devilthanh/Thesis-eSwitch-Project/Assets/sanpham.jpg

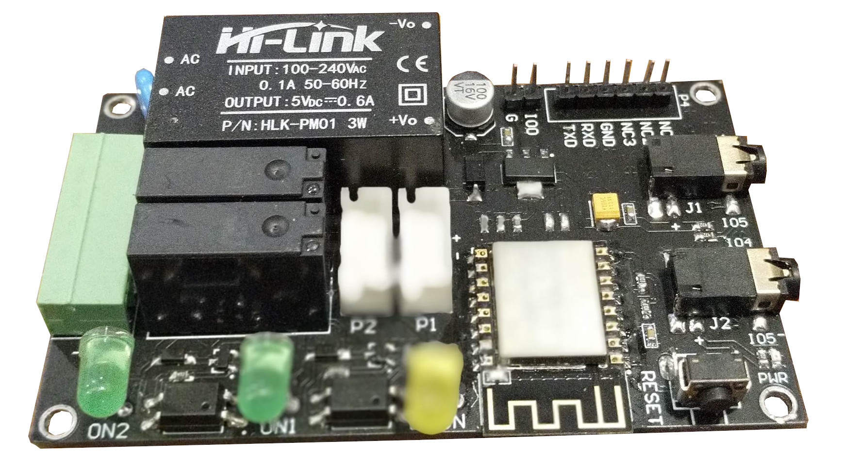
Assets/sanpham.jpg
