devilthanh/Thesis-eSwitch-Project/README.md

# [Thesis] eSwitch Project by Vo Ha Thanh
