devilthanh/Thesis-eSwitch-Project/Assets/sodokhoimach.docx

01 LED thông báo trạng thái mạng

02 relay HF46

02 LED trạng thái relay

02 cảm biến giao tiếp I2C qua jack audio 3.5mmm

02 nút nhấn cảm ứng điện dung

Nguồn Hi-link HLK-PM01 5VDC 3W

01 LED nguồn

ASM1117 3.3V

MCU

ESP8266-12F
