devilthanh/Thesis-eSwitch-Project/Assets/sodofirmware.docx

Save

Load

HTTPS

…

Firebase

Bộ nhớ EEPROM ảo để lưu các thiết lập cần thiết

Vòng lặp của đối tượng xử lý chính

Danh sách liên kết chứa các đối tượng thiết bị.

Bắt đầu

Thiết bị 1

Thiết bị 2

Thiết bị 3

Thiết bị n
