devilthanh/Thesis-eSwitch-Project/Assets/sodokhoitongquat.docx

…

Hệ thống nhiều thiết bị của người dùng n

Hệ thống nhiều thiết bị của người dùng 2

Hệ thống nhiều thiết bị của người dùng 1

…

Web App/

Mobile App

Người dùng n

Firebase Realtime Database

Web App/

Mobile App

Người dùng 2

Người dùng 1

Web App/

Mobile App
