devilthanh/Thesis-eSwitch-Project/Assets/sodoweb.docx

Thao tác của người dùng

Cập nhật giao diện

Sự kiện thao tác

Giao diện được thiết kế bằng HTML và CSS

HTTPS

Chương trình chính của giao diện được xử lý bằng Javascript

Firebase Realtime Datase
