devilthanh/Thesis-eSwitch-Project/Assets/2D.png

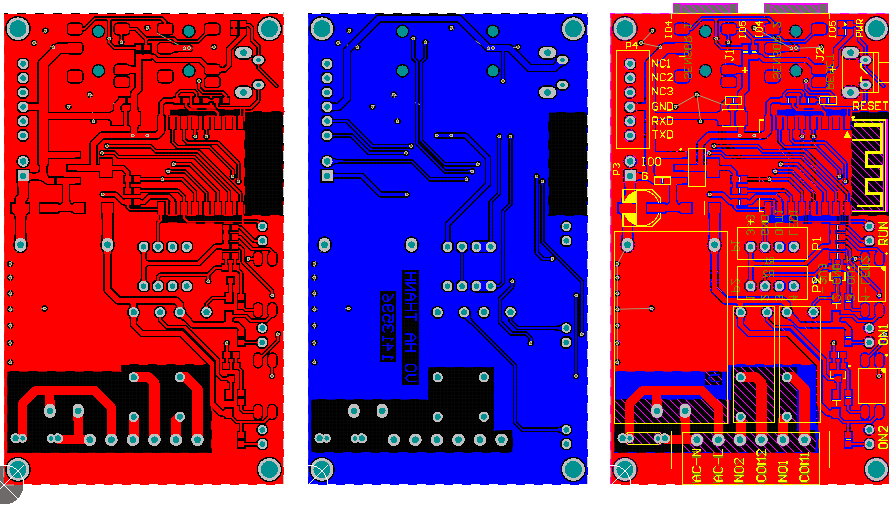
Assets/2D.png
