devilthanh/Thesis-eSwitch-Project/Assets/2D_BOT.PNG

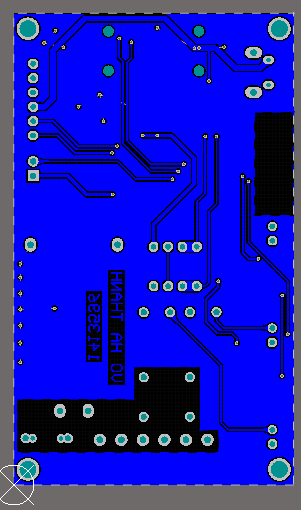
Assets/2D_BOT.PNG
