devilthanh/Thesis-eSwitch-Project/Assets/2D_OVR.PNG

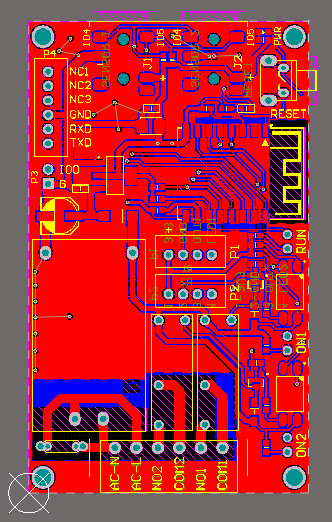
Assets/2D_OVR.PNG
