devilthanh/Thesis-eSwitch-Project/Assets/2D_TOP.PNG

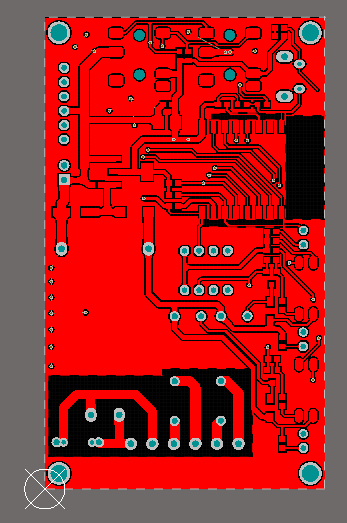
Assets/2D_TOP.PNG
