devilthanh/Thesis-eSwitch-Project/Assets/3D_PCB.PNG

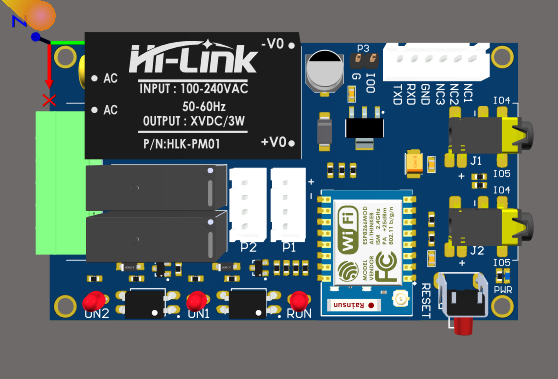
Assets/3D_PCB.PNG
