devilthanh/Thesis-eSwitch-Project/Assets/bk.jpg

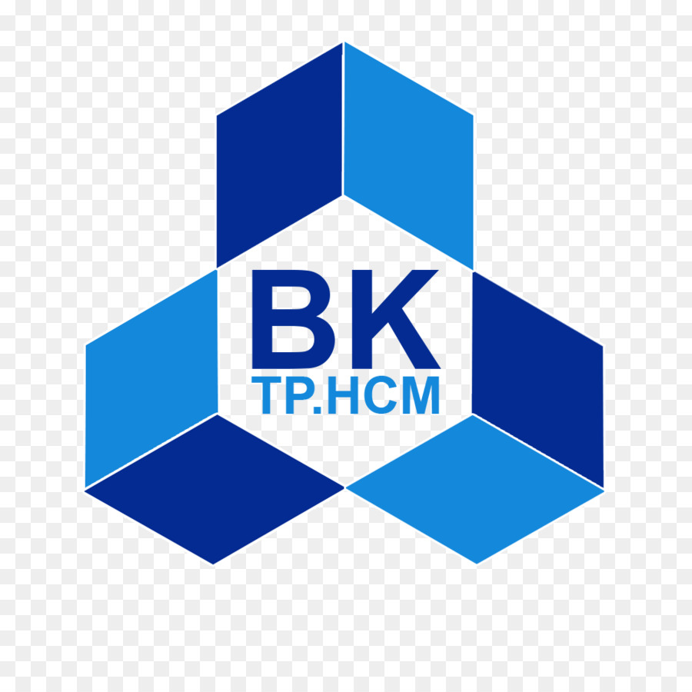
Assets/bk.jpg
