devilthanh/Thesis-eSwitch-Project/Assets/decal.png

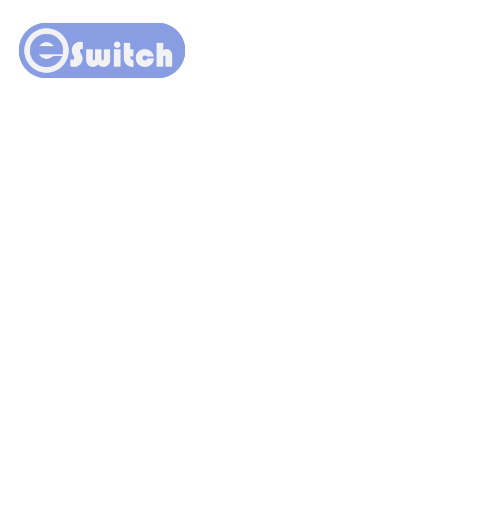
Assets/decal.png
